olegantonyan/esp32dif/hardware/esp32dif.kicad_sch

## KiCad design hardware/esp32dif.kicad_sch (2026-11-14)

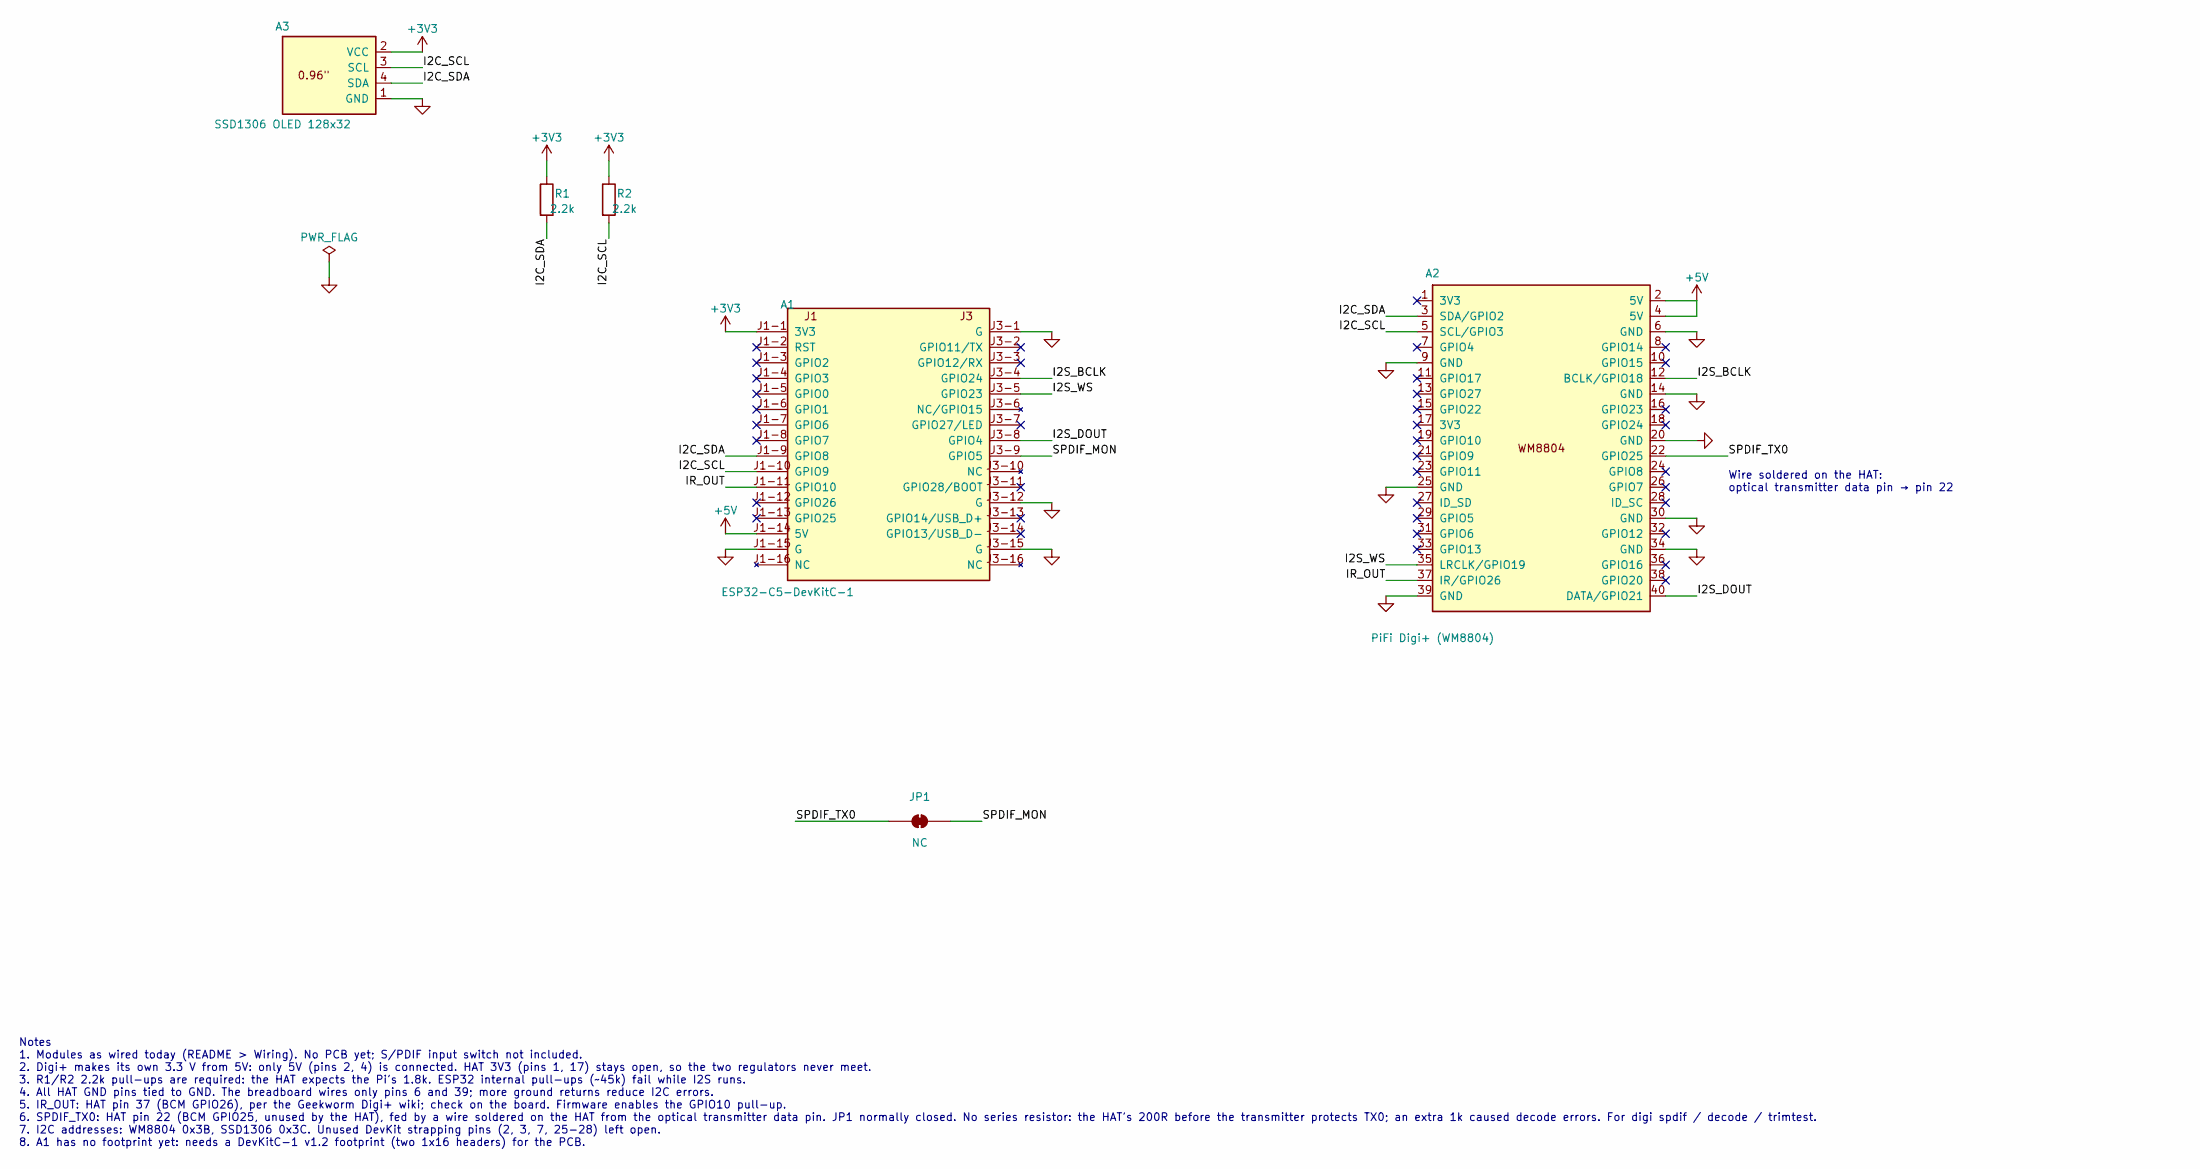
[picture p1: schematic esp32dif.kicad_sch]

Parts:
A1: ESP32-C5-DevKitC-1; MPN ESP32-C5-DevKitC-1-N8R8
A2: PiFi Digi+ (WM8804); PinHeader_2x20_P2.54mm_Vertical
A3: SSD1306 OLED 128x32; PinSocket_1x04_P2.54mm_Vertical
JP1: NC; SolderJumper-2_P1.3mm_Bridged_RoundedPad1.0x1.5mm
R1, R2: 2.2k; R_0805_2012Metric

Connections:
+3V3: A1.J1-1 (3V3), A3.2 (VCC), R1.1, R2.1
+5V: A1.J1-14 (5V), A2.2 (5V), A2.4 (5V)
GND: A1.J1-15 (G), A1.J3-1 (G), A1.J3-12 (G), A1.J3-15 (G), A2.6 (GND), A2.9 (GND), A2.14 (GND), A2.20 (GND), A2.25 (GND), A2.30 (GND), A2.34 (GND), A2.39 (GND), A3.1 (GND)
I2C_SCL: A1.J1-10 (GPIO9), A2.5 (SCL/GPIO3), A3.3 (SCL), R2.2
I2C_SDA: A1.J1-9 (GPIO8), A2.3 (SDA/GPIO2), A3.4 (SDA), R1.2
I2S_BCLK: A1.J3-4 (GPIO24), A2.12 (BCLK/GPIO18)
I2S_DOUT: A1.J3-8 (GPIO4), A2.40 (DATA/GPIO21)
I2S_WS: A1.J3-5 (GPIO23), A2.35 (LRCLK/GPIO19)
IR_OUT: A1.J1-11 (GPIO10), A2.37 (IR/GPIO26)
SPDIF_MON: A1.J3-9 (GPIO5), JP1.2 (B)
SPDIF_TX0: A2.22 (GPIO25), JP1.1 (A)

Notes on the sheet:
Wire soldered on the HAT: optical transmitter data pin → pin 22
Notes 1. Modules as wired today (README > Wiring). No PCB yet; S/PDIF input switch not included. 2. Digi+ makes its own 3.3 V from 5V: only 5V (pins 2, 4) is connected. HAT 3V3 (pins 1, 17) stays open, so the two regulators never meet. 3. R1/R2 2.2k pull-ups are required: the HAT expects the Pi's 1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
