olegantonyan/esp32dif/hardware/spdif-switch/spdif-switch.kicad_sch

## KiCad design hardware/spdif-switch/spdif-switch.kicad_sch (2026-11-12)

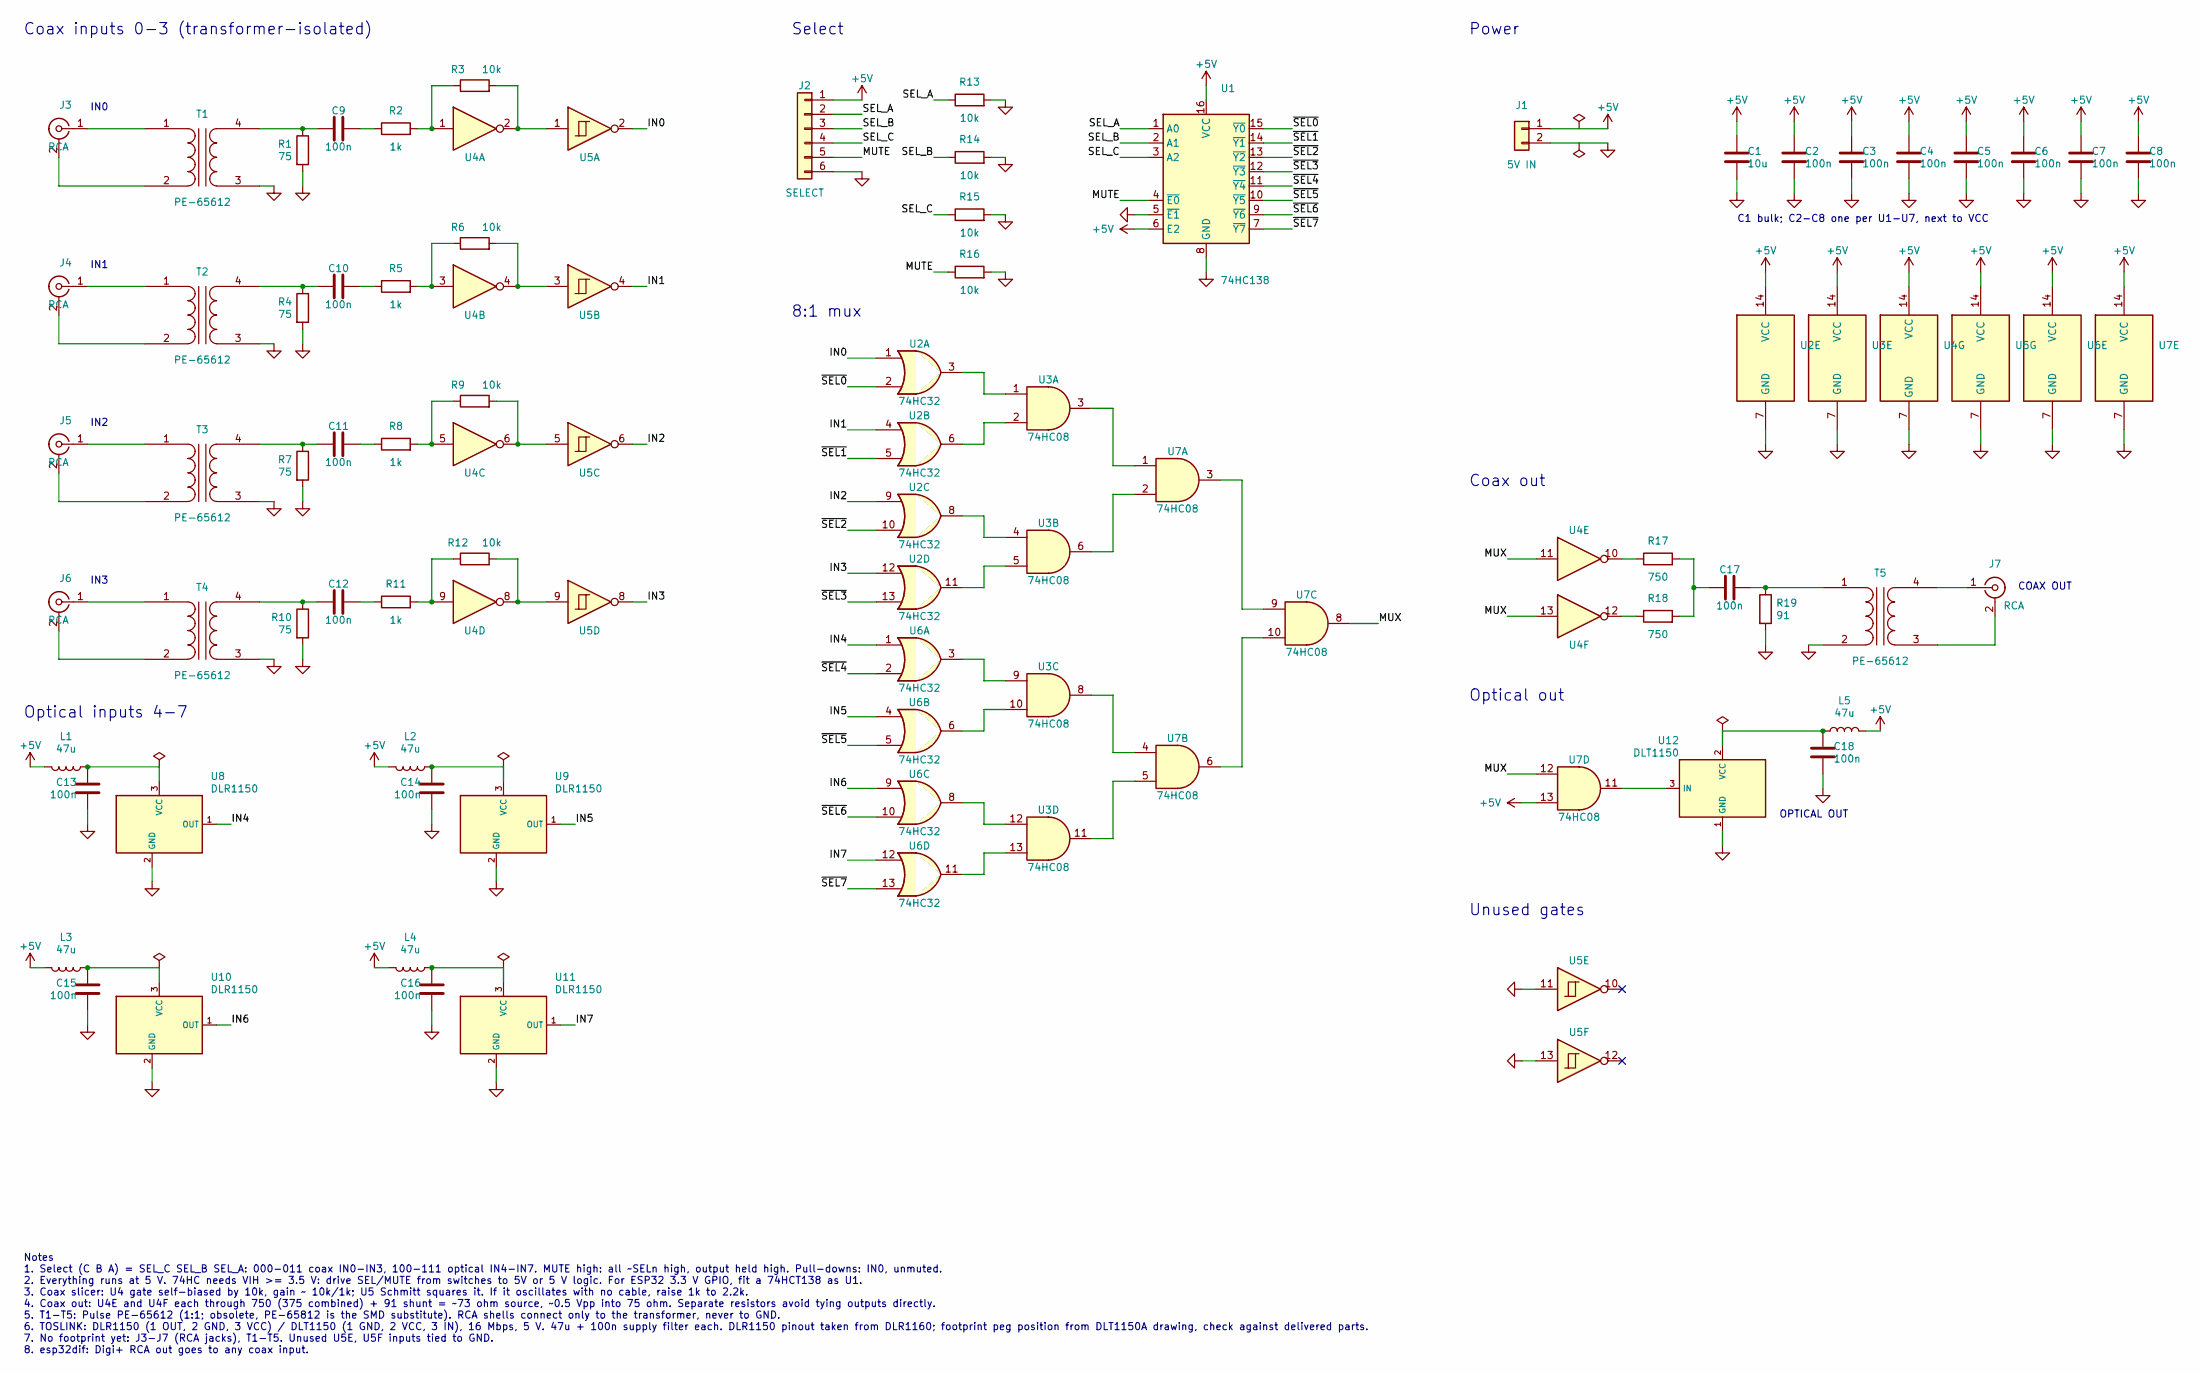
[picture p2: schematic spdif-switch.kicad_sch]

Parts:
C1: 10u; C_0805_2012Metric
C2, C3, C4, C5, C6, C7, C8, C9, C10, C11, C12, C13, C14, C15, C16, C17, C18: 100n; C_0805_2012Metric
J1: 5V IN; PinHeader_1x02_P2.54mm_Vertical
J2: SELECT; PinHeader_1x06_P2.54mm_Vertical
J3, J4, J5, J6, J7: RCA
L1, L2, L3, L4, L5: 47u; L_1210_3225Metric
R1, R4, R7, R10: 75; R_0805_2012Metric
R2, R5, R8, R11: 1k; R_0805_2012Metric
R3, R6, R9, R12, R13, R14, R15, R16: 10k; R_0805_2012Metric
R17, R18: 750; R_0805_2012Metric
R19: 91; R_0805_2012Metric
T1, T2, T3, T4, T5: PE-65612; MPN PE-65612
U1: 74HC138; DIP-16_W7.62mm
U2, U6: 74HC32; DIP-14_W7.62mm
U3, U7: 74HC08; DIP-14_W7.62mm
U4: 74HC04; DIP-14_W7.62mm
U5: 74HC14; DIP-14_W7.62mm
U8, U9, U10, U11: DLR1150; DLR1150_DLT1150
U12: DLT1150; DLR1150_DLT1150

Connections:
+5V: C1.1, C2.1, C3.1, C4.1, C5.1, C6.1, C7.1, C8.1, J1.1, J2.1, L1.2, L2.2, L3.2, L4.2, L5.2, U1.6 (E2), U1.16 (VCC), U2.14 (VCC), U3.14 (VCC), U4.14 (VCC), U5.14 (VCC), U6.14 (VCC), U7.13, U7.14 (VCC)
GND: C1.2, C2.2, C3.2, C4.2, C5.2, C6.2, C7.2, C8.2, C13.2, C14.2, C15.2, C16.2, C18.2, J1.2, J2.6, R1.2, R4.2, R7.2, R10.2, R13.2, R14.2, R15.2, R16.2, R19.2, T1.3 (SA), T2.3 (SA), T3.3 (SA), T4.3 (SA), T5.2 (AB), U1.5 (~E1), U1.8 (GND), U2.7 (GND), U3.7 (GND), U4.7 (GND), U5.7 (GND), U5.11, U5.13, U6.7 (GND), U7.7 (GND), U8.2 (GND), U9.2 (GND), U10.2 (GND), U11.2 (GND), U12.1 (GND)
IN0: U2.1, U5.2
IN1: U2.4, U5.4
IN2: U2.9, U5.6
IN3: U2.12, U5.8
IN4: U6.1, U8.1 (OUT)
IN5: U6.4, U9.1 (OUT)
IN6: U6.9, U10.1 (OUT)
IN7: U6.12, U11.1 (OUT)
MUTE: J2.5, R16.1, U1.4 (~E0)
MUX: U4.11, U4.13, U7.8, U7.12
unnamed: C9.1, R1.1, T1.4 (SB)
unnamed: C9.2, R2.1
unnamed: C10.1, R4.1, T2.4 (SB)
unnamed: C10.2, R5.1
unnamed: C11.1, R7.1, T3.4 (SB)
unnamed: C11.2, R8.1
unnamed: C12.1, R10.1, T4.4 (SB)
unnamed: C12.2, R11.1
unnamed: C13.1, L1.1, U8.3 (VCC)
unnamed: C14.1, L2.1, U9.3 (VCC)
unnamed: C15.1, L3.1, U10.3 (VCC)
unnamed: C16.1, L4.1, U11.3 (VCC)
unnamed: C17.1, R17.2, R18.2
unnamed: C17.2, R19.1, T5.1 (AA)
unnamed: C18.1, L5.1, U12.2 (VCC)
unnamed: J3.1 (In), T1.1 (AA)
unnamed: J3.2 (Ext), T1.2 (AB)
unnamed: J4.1 (In), T2.1 (AA)
unnamed: J4.2 (Ext), T2.2 (AB)
unnamed: J5.1 (In), T3.1 (AA)
unnamed: J5.2 (Ext), T3.2 (AB)
unnamed: J6.1 (In), T4.1 (AA)
unnamed: J6.2 (Ext), T4.2 (AB)
unnamed: J7.1 (In), T5.4 (SB)
unnamed: J7.2 (Ext), T5.3 (SA)
unnamed: R2.2, R3.1, U4.1
unnamed: R3.2, U4.2, U5.1
unnamed: R5.2, R6.1, U4.3
unnamed: R6.2, U4.4, U5.3
unnamed: R8.2, R9.1, U4.5
unnamed: R9.2, U4.6, U5.5
unnamed: R11.2, R12.1, U4.9
unnamed: R12.2, U4.8, U5.9
unnamed: R17.1, U4.10
unnamed: R18.1, U4.12
unnamed: U2.3, U3.1
unnamed: U2.6, U3.2
unnamed: U2.8, U3.4
unnamed: U2.11, U3.5
unnamed: U3.3, U7.1
unnamed: U3.6, U7.2
unnamed: U3.8, U7.4
unnamed: U3.9, U6.3
unnamed: U3.10, U6.6
unnamed: U3.11, U7.5
unnamed: U3.12, U6.8
unnamed: U3.13, U6.11
unnamed: U7.3, U7.9
unnamed: U7.6, U7.10
unnamed: U7.11, U12.3 (IN)
SEL_A: J2.2, R13.1, U1.1 (A0)
SEL_B: J2.3, R14.1, U1.2 (A1)
SEL_C: J2.4, R15.1, U1.3 (A2)
~SEL0: U1.15 (~Y0), U2.2
~SEL1: U1.14 (~Y1), U2.5
~SEL2: U1.13 (~Y2), U2.10
~SEL3: U1.12 (~Y3), U2.13
~SEL4: U1.11 (~Y4), U6.2
~SEL5: U1.10 (~Y5), U6.5
~SEL6: U1.9 (~Y6), U6.10
~SEL7: U1.7 (~Y7), U6.13

Notes on the sheet:
Power
C1 bulk; C2-C8 one per U1-U7, next to VCC
Coax inputs 0-3 (transformer-isolated)
IN0
IN1
IN2
IN3
Optical inputs 4-7
Select
8:1 mux
Coax out
COAX OUT
Optical out
OPTICAL OUT
Unused gates
Notes 1. Select (C B A) = SEL_C SEL_B SEL_A: 000-011 coax IN0-IN3, 100-111 optical IN4-IN7. MUTE high: all ~SELn high, output held high. Pull-downs: IN0, unmuted. 2. Everything runs at 5 V. 74HC needs VIH >= 3.5 V: drive SEL/MUTE from switches to 5V or 5 V logic. For ESP32 3.3 V GPIO, fit a 74HCT13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
