olegantonyan/esp32dif/(commit log)

2026-11-08 rename project; web ui; telnet; auth; ota
    [partitions.csv]
2026-11-08 rgb led follows device state
2026-11-08 add oled timeout to prevent burnout
    [cmd_oled.c, oled.c, oled.h, status_oled.c]
2026-11-11 add kicad schematic
    [esp32dif.kicad_sch]
2026-11-11 add current track info to oled
2026-11-12 add spdif-switch schematic
    [spdif-switch.kicad_sch]
2026-11-12 up spdif scwitch schematics
    [spdif-switch.kicad_sch]
2026-11-12 up spdif mon pin schematic
    [esp32dif.kicad_sch]
2026-11-14 change oled module
    [esp32dif.kicad_sch]
